SuperRadMaker/golf-ball-returner/images/gear_detail.png

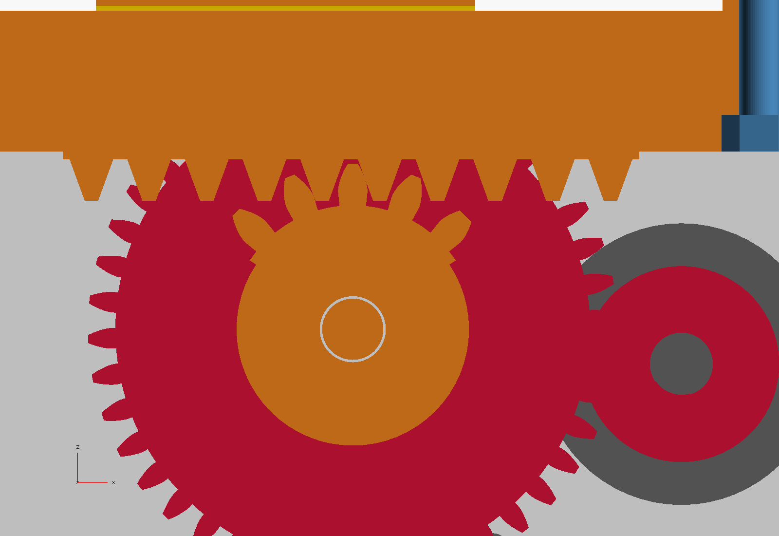
images/gear_detail.png
