SuperRadMaker/golf-ball-returner/images/section_engaged.png

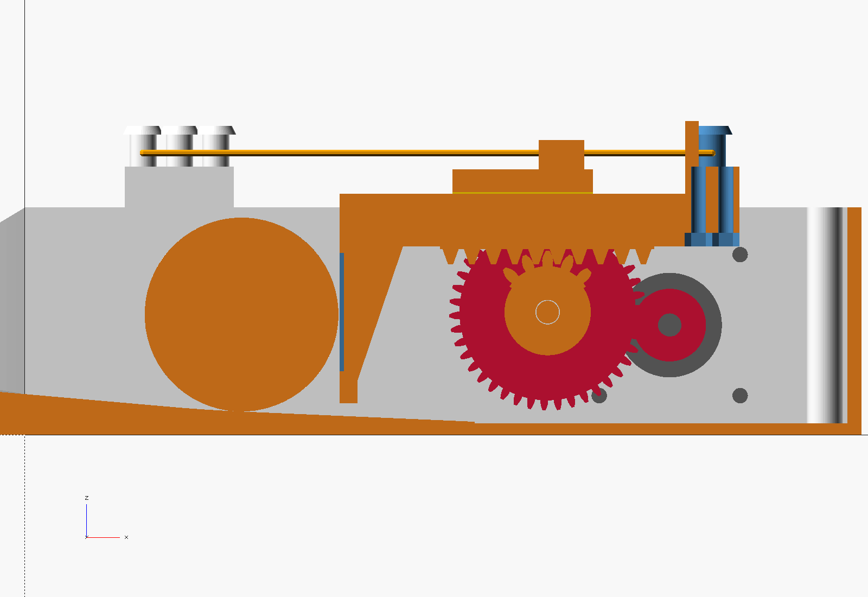
images/section_engaged.png
