SuperRadMaker/golf-ball-returner/images/top_view.png

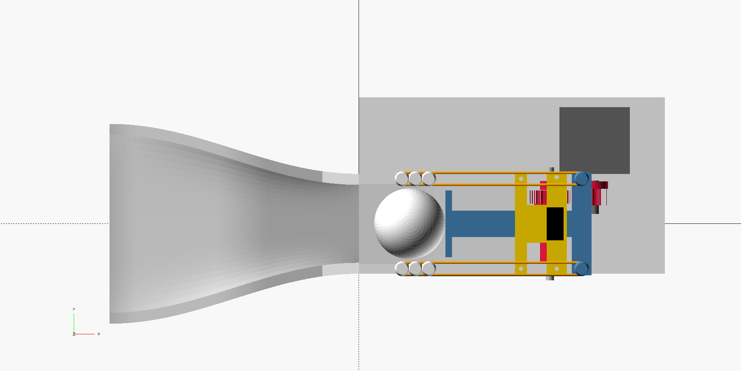
images/top_view.png
