SuperRadMaker/golf-ball-returner/stl/spacer.stl

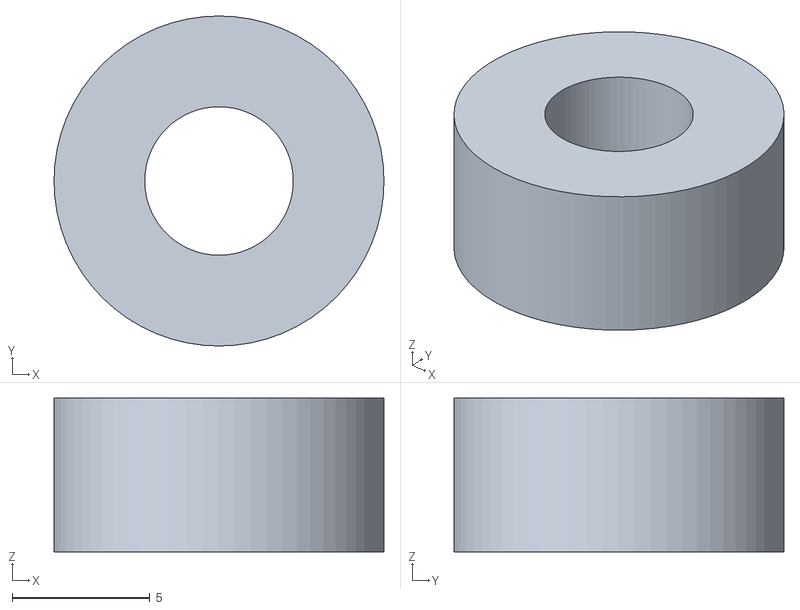
[picture p9: CAD file, 2026-10-01]
stl/spacer.stl
12.0 x 12.0 x 5.60
