SuperRadMaker/golf-ball-returner/stl/sector.stl

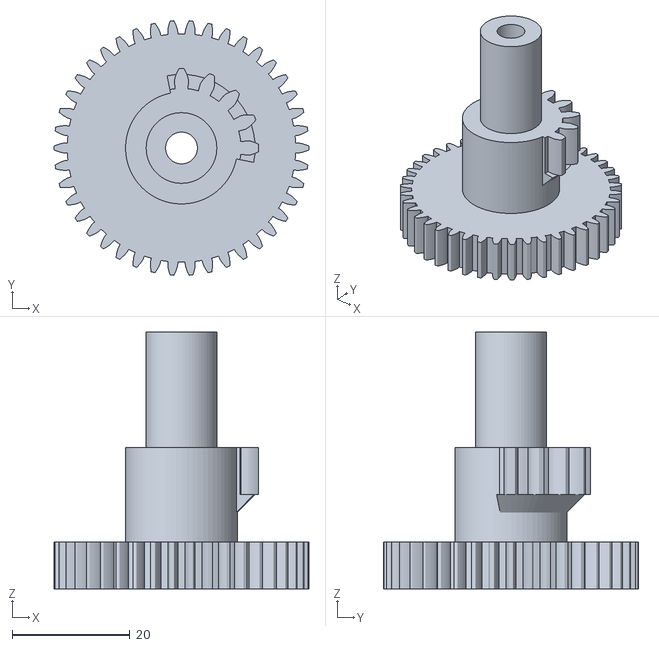
[picture p10: CAD file, 2026-10-01]
stl/sector.stl
43.3 x 43.2 x 43.6
