SuperRadMaker/golf-ball-returner/stl/crossbar.stl

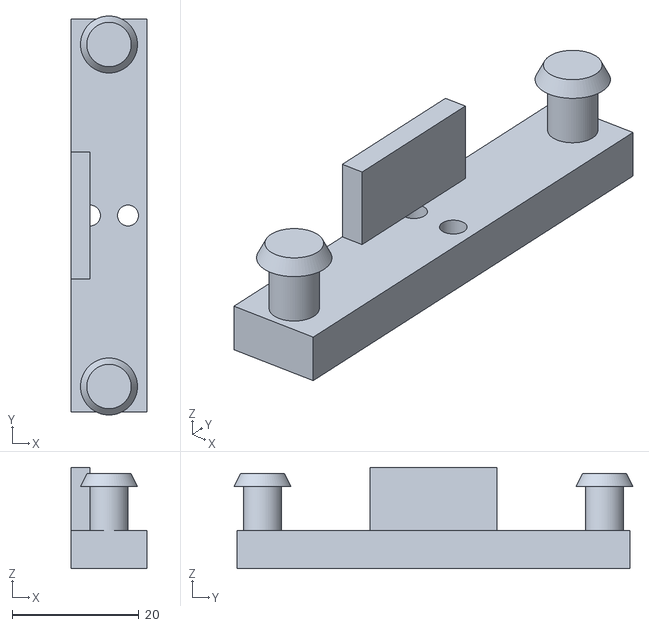
[picture p11: CAD file, 2026-10-01]
stl/crossbar.stl
12.0 x 63.0 x 16.0
