SuperRadMaker/golf-ball-returner/stl/ramp.stl

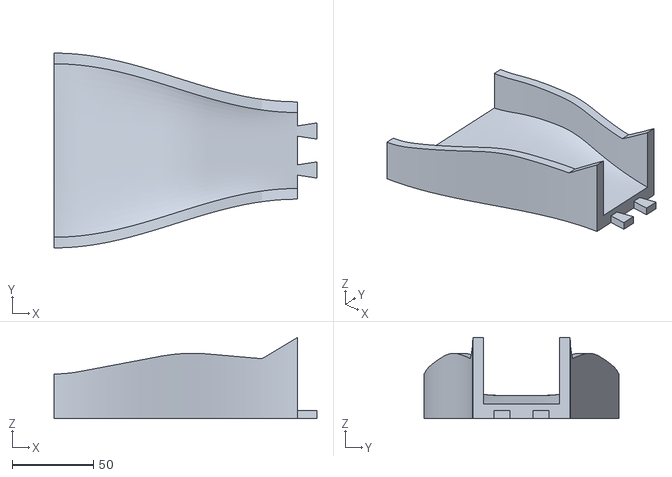
[picture p12: CAD file, 2026-10-01]
stl/ramp.stl
162.0 x 120.0 x 50.0
