SuperRadMaker/golf-ball-returner/stl/sled.stl

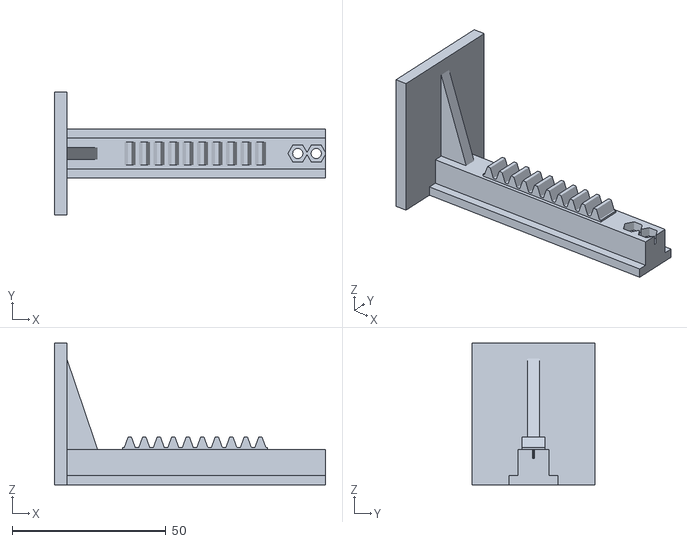
[picture p13: CAD file, 2026-10-01]
stl/sled.stl
88.0 x 40.0 x 46.0
