SuperRadMaker/golf-ball-returner/stl/pinion.stl

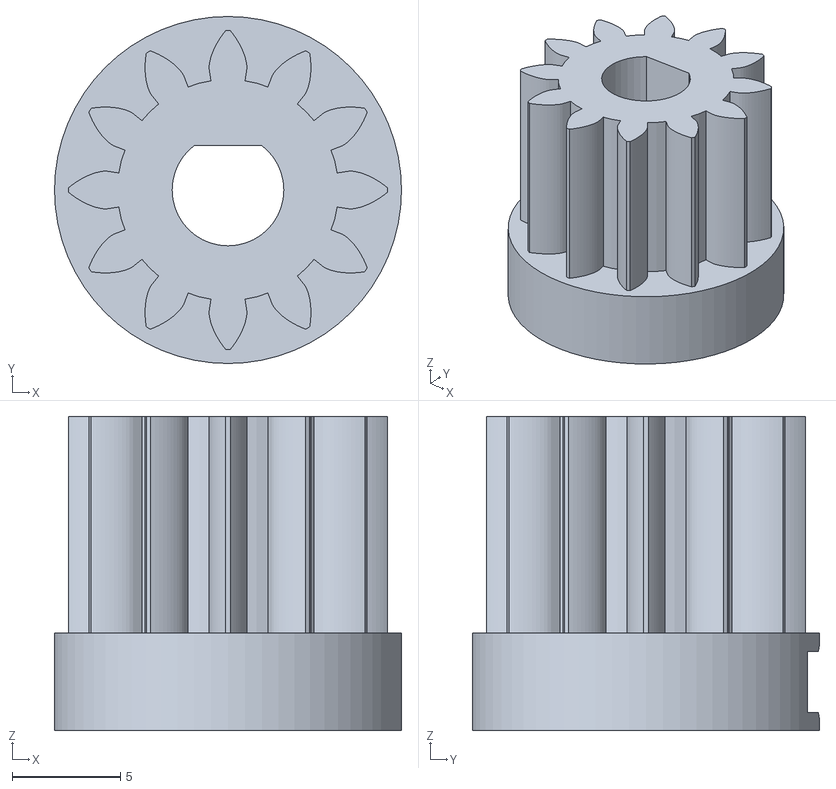
[picture p14: CAD file, 2026-10-01]
stl/pinion.stl
16.0 x 16.0 x 14.5
