SuperRadMaker/golf-ball-returner/stl/base.stl

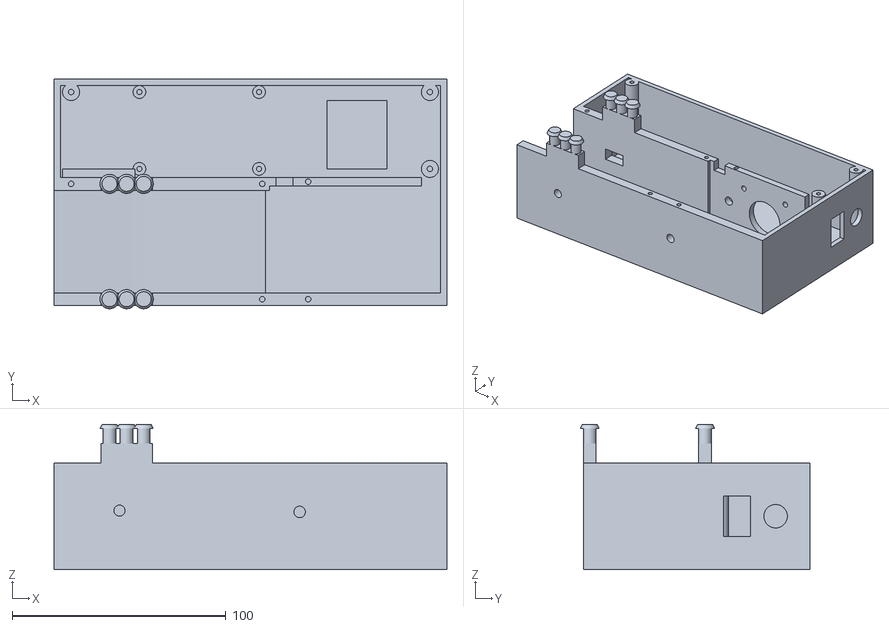
[picture p15: CAD file, 2026-10-01]
stl/base.stl
184.0 x 107.5 x 68.0
