SuperRadMaker/golf-ball-returner/stl/lid.stl

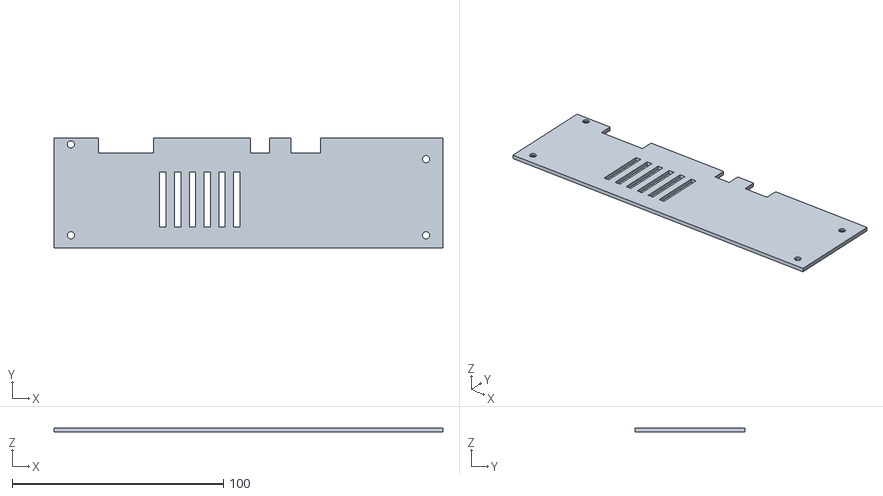
[picture p16: CAD file, 2026-10-01]
stl/lid.stl
184.0 x 52.0 x 2.00
