SuperRadMaker/golf-ball-returner/stl/guide.stl

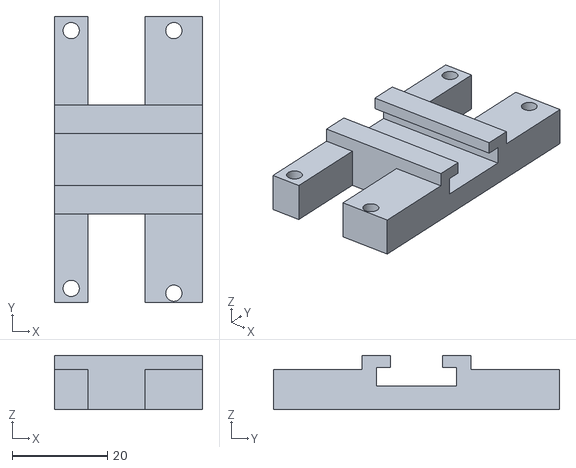
[picture p17: CAD file, 2026-10-01]
stl/guide.stl
31.0 x 60.0 x 11.4
