SuperRadMaker/golf-ball-returner/cad/stroke_table.scad

// generated by docs/sector_sim.py - sled travel (mm) vs sector angle (deg)
stroke_sim = 33.42;
snap_deg = 265.75;
eng_deg_sim = 100.00;
stroke_tbl = [
    [0, 0.000],
    [1, 0.000],
    [2, 0.000],
    [3, 0.000],
    [4, 0.000],
    [5, 0.000],
    [6, 0.000],
    [7, 0.000],
    [8, 0.000],
    [9, 0.000],
    [10, 0.000],
    [11, 0.000],
    [12, 0.000],
    [13, 0.000],
    [14, 0.000],
    [15, 0.000],
    [16, 0.000],
    [17, 0.000],
    [18, 0.000],
    [19, 0.000],
    [20, 0.000],
    [21, 0.000],
    [22, 0.000],
    [23, 0.000],
    [24, 0.000],
    [25, 0.000],
    [26, 0.000],
    [27, 0.000],
    [28, 0.000],
    [29, 0.000],
    [30, 0.000],
    [31, 0.000],
    [32, 0.000],
    [33, 0.000],
    [34, 0.000],
    [35, 0.000],
    [36, 0.000],
    [37, 0.000],
    [38, 0.000],
    [39, 0.000],
    [40, 0.000],
    [41, 0.000],
    [42, 0.000],
    [43, 0.000],
    [44, 0.000],
    [45, 0.000],
    [46, 0.000],
    [47, 0.000],
    [48, 0.000],
    [49, 0.000],
    [50, 0.000],
    [51, 0.000],
    [52, 0.000],
    [53, 0.000],
    [54, 0.000],
    [55, 0.000],
    [56, 0.000],
    [57, 0.000],
    [58, 0.000],
    [59, 0.000],
    [60, 0.000],
    [61, 0.000],
    [62, 0.000],
    [63, 0.000],
    [64, 0.000],
    [65, 0.000],
    [66, 0.000],
    [67, 0.000],
    [68, 0.000],
    [69, 0.000],
    [70, 0.000],
    [71, 0.000],
    [72, 0.000],
    [73, 0.000],
    [74, 0.000],
    [75, 0.000],
    [76, 0.000],
    [77, 0.000],
    [78, 0.000],
    [79, 0.000],
    [80, 0.000],
    [81, 0.000],
    [82, 0.000],
    [83, 0.000],
    [84, 0.000],
    [85, 0.000],
    [86, 0.000],
    [87, 0.000],
    [88, 0.000],
    [89, 0.000],
    [90, 0.000],
    [91, 0.000],
    [92, 0.000],
    [93, 0.000],
    [94, 0.000],
    [95, 0.000],
    [96, 0.000],
    [97, 0.000],
    [98, 0.000],
    [99, 0.000],
    [100, 0.040],
    [101, 0.350],
    [102, 0.640],
    [103, 0.910],
    [104, 1.170],
    [105, 1.420],
    [106, 1.660],
    [107, 1.890],
    [108, 2.110],
    [109, 2.330],
    [110, 2.540],
    [111, 2.750],
    [112, 2.950],
    [113, 3.160],
    [114, 3.370],
    [115, 3.580],
    [116, 3.790],
    [117, 4.000],
    [118, 4.210],
    [119, 4.420],
    [120, 4.630],
    [121, 4.840],
    [122, 5.050],
    [123, 5.260],
    [124, 5.470],
    [125, 5.680],
    [126, 5.890],
    [127, 6.100],
    [128, 6.310],
    [129, 6.520],
    [130, 6.730],
    [131, 6.940],
    [132, 7.150],
    [133, 7.360],
    [134, 7.570],
    [135, 7.770],
    [136, 7.980],
    [137, 8.190],
    [138, 8.400],
    [139, 8.610],
    [140, 8.820],
    [141, 9.030],
    [142, 9.240],
    [143, 9.450],
    [144, 9.660],
    [145, 9.870],
    [146, 10.080],
    [147, 10.290],
    [148, 10.500],
    [149, 10.710],
    [150, 10.910],
    [151, 11.120],
    [152, 11.330],
    [153, 11.540],
    [154, 11.750],
    [155, 11.960],
    [156, 12.170],
    [157, 12.380],
    [158, 12.590],
    [159, 12.800],
    [160, 13.010],
    [161, 13.220],
    [162, 13.430],
    [163, 13.640],
    [164, 13.850],
    [165, 14.060],
    [166, 14.270],
    [167, 14.480],
    [168, 14.690],
    [169, 14.900],
    [170, 15.100],
    [171, 15.310],
    [172, 15.520],
    [173, 15.730],
    [174, 15.940],
    [175, 16.150],
    [176, 16.360],
    [177, 16.570],
    [178, 16.780],
    [179, 16.990],
    [180, 17.200],
    [181, 17.410],
    [182, 17.620],
    [183, 17.830],
    [184, 18.040],
    [185, 18.250],
    [186, 18.460],
    [187, 18.670],
    [188, 18.870],
    [189, 19.080],
    [190, 19.290],
    [191, 19.500],
    [192, 19.710],
    [193, 19.920],
    [194, 20.130],
    [195, 20.340],
    [196, 20.550],
    [197, 20.760],
    [198, 20.970],
    [199, 21.180],
    [200, 21.390],
    [201, 21.600],
    [202, 21.810],
    [203, 22.020],
    [204, 22.230],
    [205, 22.430],
    [206, 22.640],
    [207, 22.850],
    [208, 23.060],
    [209, 23.270],
    [210, 23.480],
    [211, 23.690],
    [212, 23.900],
    [213, 24.110],
    [214, 24.320],
    [215, 24.530],
    [216, 24.740],
    [217, 24.950],
    [218, 25.160],
    [219, 25.370],
    [220, 25.580],
    [221, 25.790],
    [222, 25.990],
    [223, 26.200],
    [224, 26.410],
    [225, 26.620],
    [226, 26.830],
    [227, 27.040],
    [228, 27.250],
    [229, 27.460],
    [230, 27.670],
    [231, 27.880],
    [232, 28.090],
    [233, 28.300],
    [234, 28.510],
    [235, 28.720],
    [236, 28.930],
    [237, 29.130],
    [238, 29.340],
    [239, 29.540],
    [240, 29.740],
    [241, 29.940],
    [242, 30.140],
    [243, 30.330],
    [244, 30.520],
    [245, 30.710],
    [246, 30.890],
    [247, 31.070],
    [248, 31.250],
    [249, 31.430],
    [250, 31.600],
    [251, 31.770],
    [252, 31.940],
    [253, 32.100],
    [254, 32.260],
    [255, 32.420],
    [256, 32.570],
    [257, 32.720],
    [258, 32.870],
    [259, 33.010],
    [260, 33.150],
    [261, 33.290],
    [262, 33.410],
    [263, 33.420],
    [264, 33.420],
    [265, 33.420],
    [266, 0.000],
    [267, 0.000],
    [268, 0.000],
    [269, 0.000],
    [270, 0.000],
    [271, 0.000],
    [272, 0.000],
    [273, 0.000],
    [274, 0.000],
    [275, 0.000],
    [276, 0.000],
    [277, 0.000],
    [278, 0.000],
    [279, 0.000],
    [280, 0.000],
    [281, 0.000],
    [282, 0.000],
    [283, 0.000],
    [284, 0.000],
    [285, 0.000],
    [286, 0.000],
    [287, 0.000],
    [288, 0.000],
    [289, 0.000],
    [290, 0.000],
    [291, 0.000],
    [292, 0.000],
    [293, 0.000],
    [294, 0.000],
    [295, 0.000],
    [296, 0.000],
    [297, 0.000],
    [298, 0.000],
    [299, 0.000],
    [300, 0.000],
    [301, 0.000],
    [302, 0.000],
    [303, 0.000],
    [304, 0.000],
    [305, 0.000],
    [306, 0.000],
    [307, 0.000],
    [308, 0.000],
    [309, 0.000],
    [310, 0.000],
    [311, 0.000],
    [312, 0.000],
    [313, 0.000],
    [314, 0.000],
    [315, 0.000],
    [316, 0.000],
    [317, 0.000],
    [318, 0.000],
    [319, 0.000],
    [320, 0.000],
    [321, 0.000],
    [322, 0.000],
    [323, 0.000],
    [324, 0.000],
    [325, 0.000],
    [326, 0.000],
    [327, 0.000],
    [328, 0.000],
    [329, 0.000],
    [330, 0.000],
    [331, 0.000],
    [332, 0.000],
    [333, 0.000],
    [334, 0.000],
    [335, 0.000],
    [336, 0.000],
    [337, 0.000],
    [338, 0.000],
    [339, 0.000],
    [340, 0.000],
    [341, 0.000],
    [342, 0.000],
    [343, 0.000],
    [344, 0.000],
    [345, 0.000],
    [346, 0.000],
    [347, 0.000],
    [348, 0.000],
    [349, 0.000],
    [350, 0.000],
    [351, 0.000],
    [352, 0.000],
    [353, 0.000],
    [354, 0.000],
    [355, 0.000],
    [356, 0.000],
    [357, 0.000],
    [358, 0.000],
    [359, 0.000],
    [360, 0.000]];
