SuperRadMaker/golf-ball-returner/(commit log)

2026-10-01 Add rubber-band snap-kicker putting cup ball return design
    Parametric OpenSCAD model (sector gear + rack + rubber bands, NEMA17 with a
    printed 3.5:1 reduction), printable STLs, Arduino Nano firmware, 2D
    sector/rack contact simulation, band force/torque calculator, interference
    checker, wiring guide and README.
    Claude-Session: https://claude.ai/code/session_017BJtXGgmHr3MpRKKAXh1zc
    [base.stl, crossbar.stl, golf_returner.scad, guide.stl, lid.stl, pinion.stl, ramp.stl, sector.stl]
2026-10-01 Add one-file STL download and print guide
    build.sh now regenerates golf_ball_return_stl.zip from stl/ and
    docs/PRINT_GUIDE.txt so the bundle stays in sync with the parts.
    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
2026-10-01 Reshape ramp: short up-ramp, crest, longer funnel down to the paddle
    Matches the commercial layout: the ball climbs an 80 mm up-ramp (~11 deg)
    to a rounded 14 mm crest, then rolls down a ~100 mm, 5 deg funnel that
    narrows from a 108 mm cup-width mouth to the 48 mm channel and comes to rest
    on the sensor against the paddle. The floor is dished near the walls to
    centre off-line balls. One blended floor profile is shared by the ramp and
    the base so the joint is seamless.
    Also fix build.sh image sizes (duplicate --imgsize aborted the image step)
    and add a side-profile render.
    Claude-Session: https://claude.ai/code/session_017BJtXGgmHr3MpR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
    [base.stl, crossbar.stl, golf_returner.scad, guide.stl, lid.stl, pinion.stl, ramp.stl, sector.stl]
